raihanheriandry/sinam-fg3/documentation/water_level.jpg

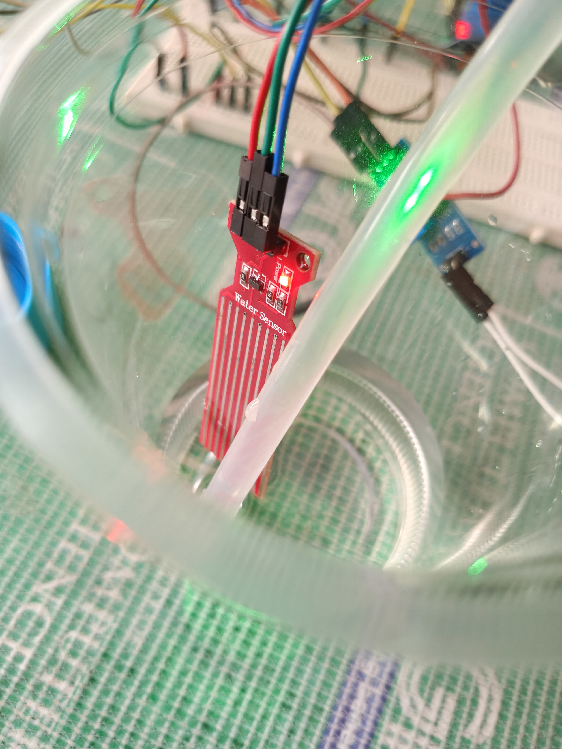
documentation/water_level.jpg
