raihanheriandry/sinam-fg3/documentation/soil.jpg

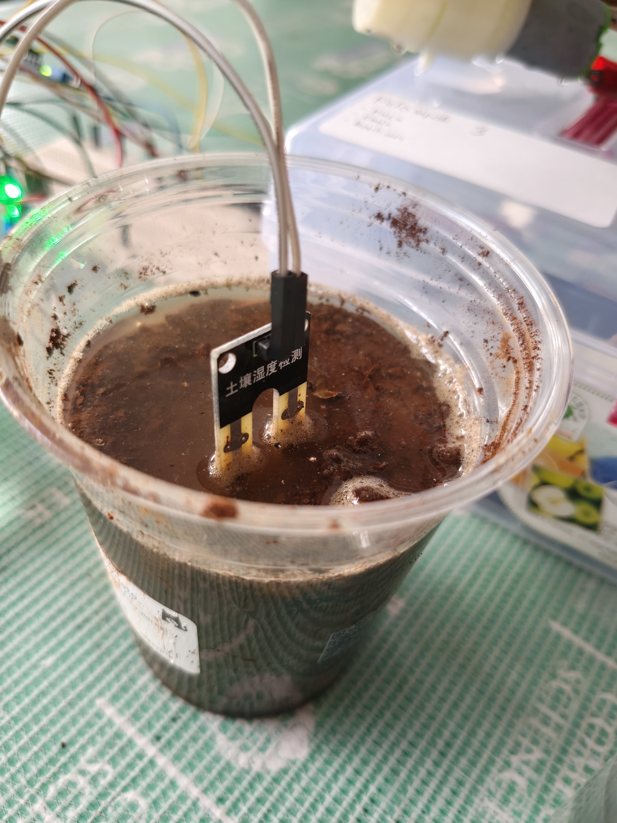
documentation/soil.jpg
