raihanheriandry/sinam-fg3/Slide_Presentasi_FG3.pdf

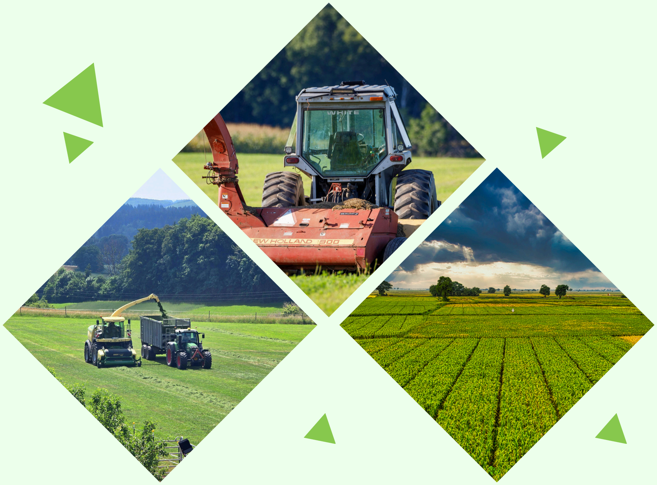
[picture p3: figure]

### Focus Group 3

Khansa Dinda Arya Putri - 2406496063 Rayyan Emir Muhammad - 2406345375 Raihan Maulana Heriandry - 2406351024

# Smart Irrigation System

### Sistem Tertanam 2026/2027

# Overview

## Sistem irigasi cerdas dirancang untuk melakukan penyiraman berdasarkan tiga kondisi utama:

## Kelembapan tanah Ketersediaan air Kondisi hujan

## Arduino Mega 2560 menerima data dari ketiga sensor dan menentukan respons dua aktuator, yaitu servo sebagai pengatur katup dan water

pump sebagai pengalir air.

### TANAH KERING

+

### AIR TERSEDIA

+

### TIDAK HUJAN

⟶

## PENYIRAMAN AKTIF

Logika Utama Sistem

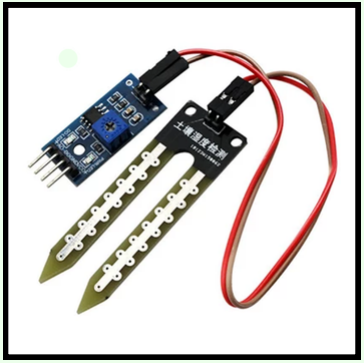
[picture p4: figure]
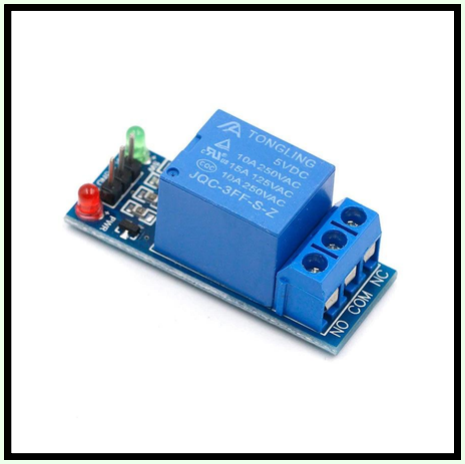
[picture p5: figure]
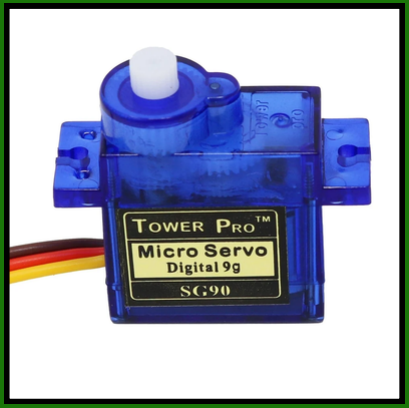
[picture p6: figure]

Servo
SG90
Sensor | Aktuator | Komponen Pendukung

Soil
Moisture
Sensor

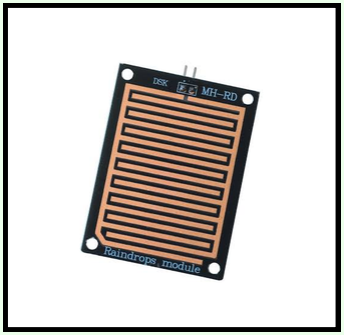
[picture p7: figure]
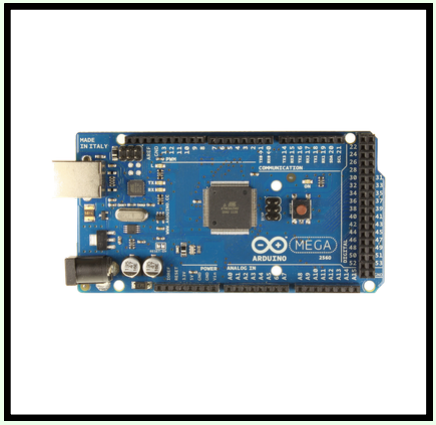
[picture p8: figure]

Raindrop
Module

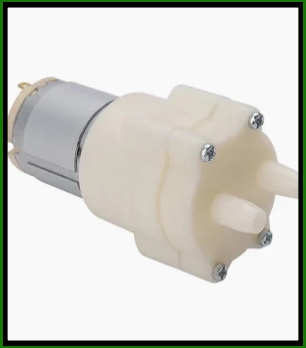
[picture p9: figure]
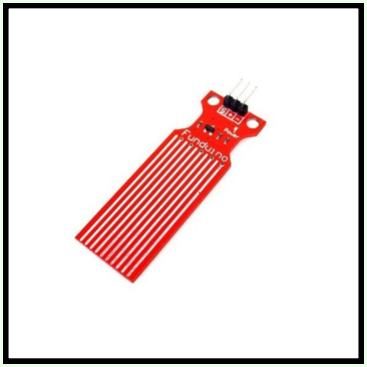
[picture p10: figure]
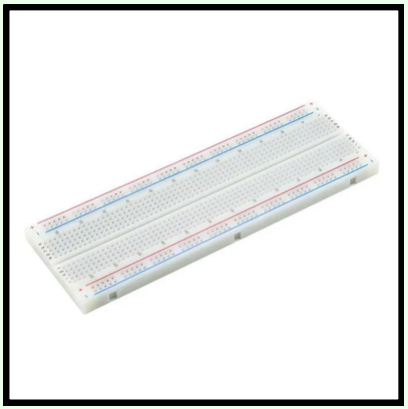
[picture p11: figure]

Water
Level
Sensor

Pump 12v

Power
Relay

Arduino
Mega 2560

Breadboard

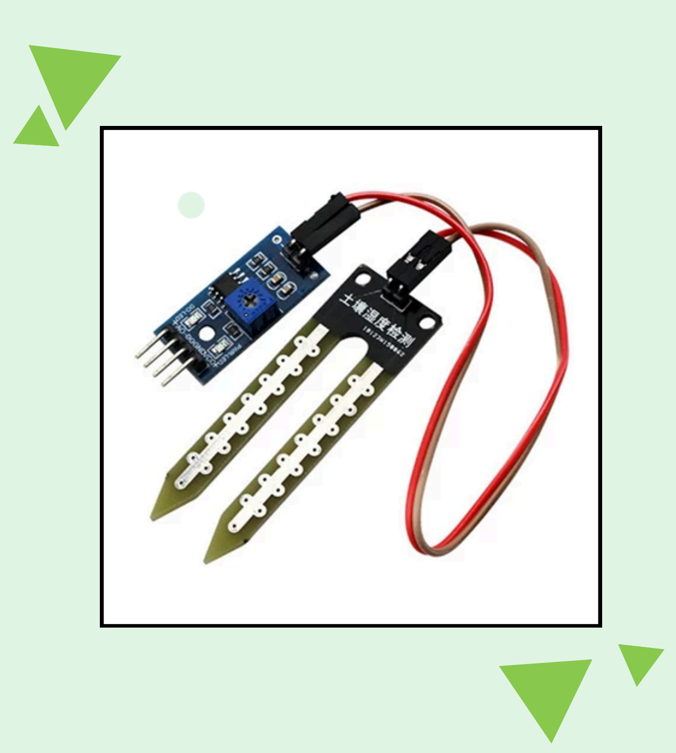
[picture p12: figure]

Fungsi:
Mendeteksi kondisi kelembapan tanah berdasarkan perubahan konduktivitas listrik pada media tanah.

Koneksi Arduino:
VCC → 5V
GND → GND
AO → Pin Analog
D0 → Pin Digital

Rentang nilai dari 0 - 1023 untuk analog. Nilai pembacaan cenderung lebih rendah pada kondisi basah dan lebih tinggi pada kondisi kering. Nilai aktual perlu dikalibrasi.

# Soil Moisture Sensor

FC-28

# Soil Moisture Sensor FC-28

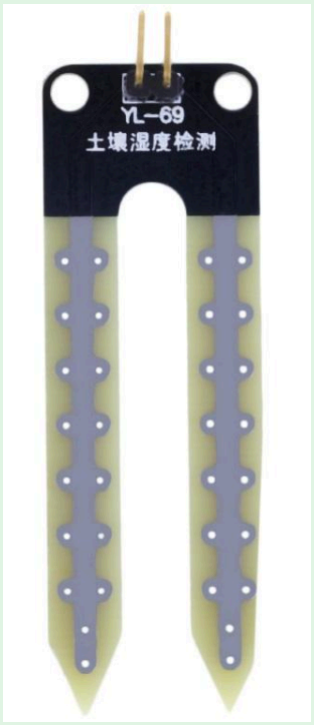
[picture p13: figure]
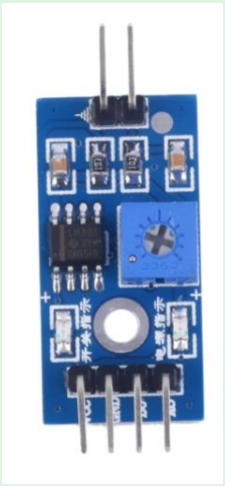
[picture p14: figure]

Probe atau garpu sensor

Dua bilah logam yang
ditancapkan ke tanah.

Sensor mendeteksi
perubahan konduktivitas
listrik | tanah | yang
berkaitan dengan kadar
airnya.

Modul pengolah sinyal

Papan biru yang mengolah sinyal sensor. Memiliki

AO (Analog Output): menghasilkan
nilai | yang | berubah | sesuai
kelembapan (0-1023).
DO (Digital Output): menghasilkan
status | HIGH/LOW | berdasarkan
ambang batas yang diatur.
Potensiometer: untuk mengatur ambang batas DO.

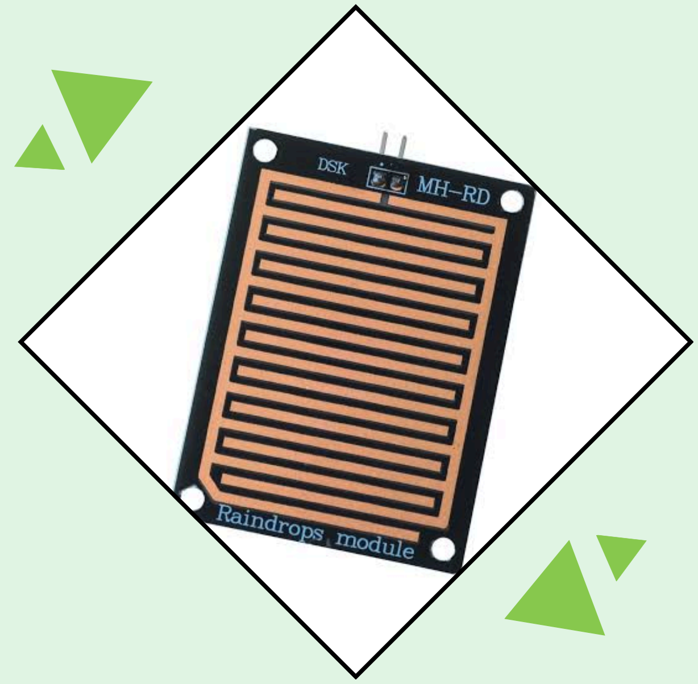
[picture p15: figure]

# Raindrop Module

Fungsi:
Mendeteksi keberadaan air atau kondisi hujan melalui perubahan karakteristik listrik pada permukaan sensor.

Koneksi Arduino:
VCC → 5V
GND → GND
AO → Pin Analog
DO → Pin Digital

Rentang nilai dari 0 - 1023 untuk analog. Nilai pembacaan cenderung lebih rendah pada kondisi basah dan lebih tinggi pada kondisi kering. Nilai aktual perlu dikalibrasi.

# Raindrop Module

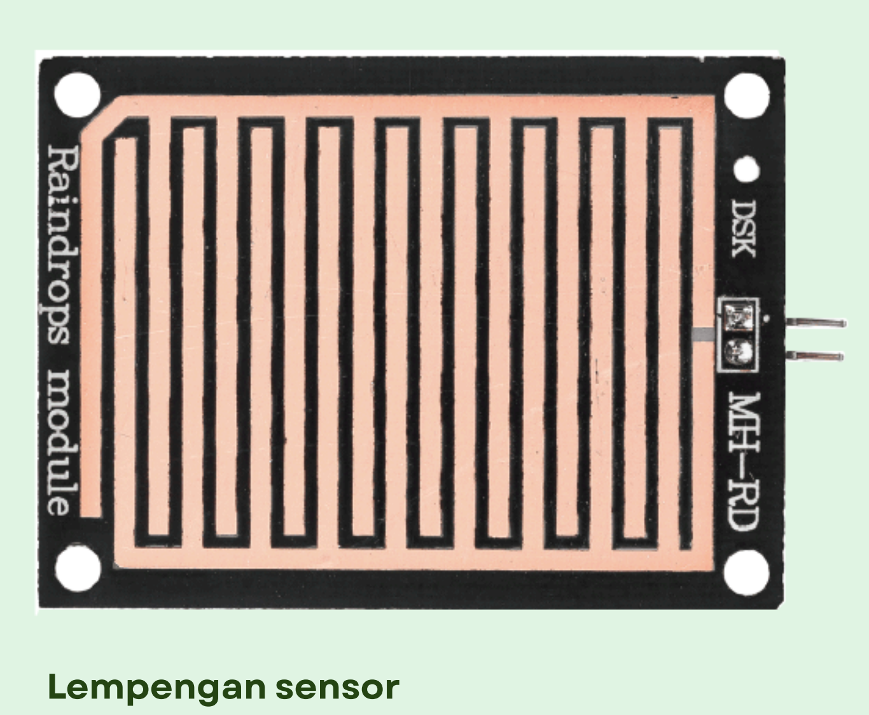
[picture p16: figure]
Lempengan sensor

Mendeteksi air atau tetesan hujan. Memiliki jalur-jalur konduktif.
Dihubungkan ke modul biru dengan 2 kabel

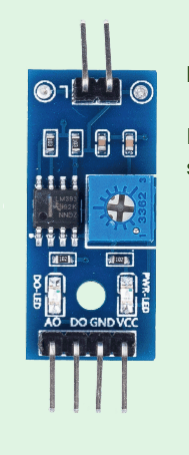
[picture p17: figure]

Modul pengolah sinyal

Papan biru yang mengolah sinyal sensor. Memiliki

AO (Analog Output): menghasilkan
nilai | yang | berubah | sesuai
kelembapan (0-1023).
DO (Digital Output): menghasilkan
status | HIGH/LOW | berdasarkan
ambang batas yang diatur.
Potensiometer: untuk mengatur ambang batas DO.

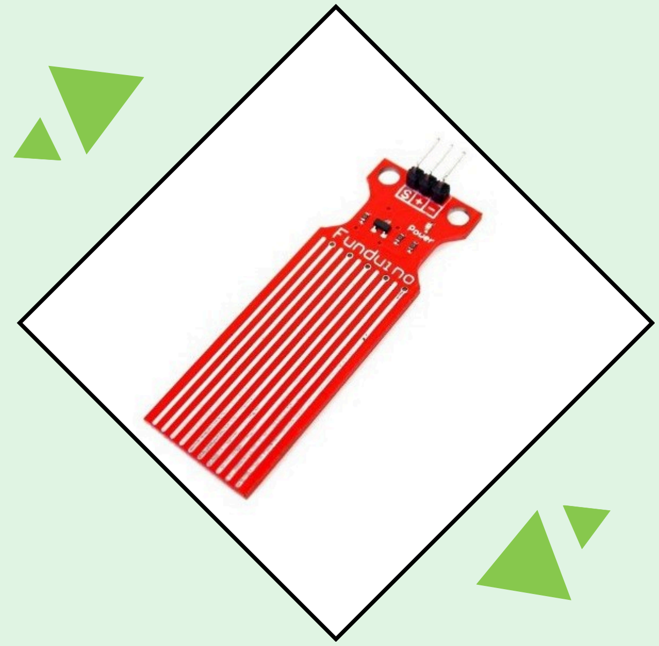
[picture p18: figure]

# Water Level Sensor ARD2-3025

Fungsi:
Mendeteksi ketersediaan air pada wadah penampungan berdasarkan perubahan sinyal analog ketika permukaan sensor bersentuhan dengan air.
Koneksi Arduino:
VCC → 5V
GND → GND
S ⟶ A1
Rentang nilai dari 0 - 1023
0 berarti air sangat rendah 1023 berarti air sangat tinggi

# Micro Servo SG90

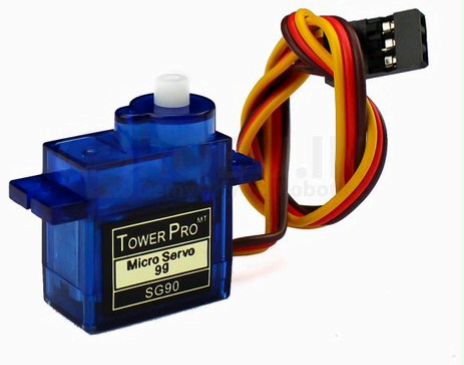
[picture p19: figure]

Fungsi:
Mengatur posisi katup air berdasarkan sinyal kontrol dari Arduino.

Koneksi Arduino:
Signal → D9
VCC → 5V
GND → GND

Menggunakan library Servo.h dengan fungsi writeMicroseconds() 1000 µs → Katup tertutup
1500 µs → Katup terbuka
Lebar pulsa tersebut menentukan posisi target servo dan dapat disesuaikan berdasarkan pemasangan mekanis katup.

# Pompa 12V (Water Pump R385)

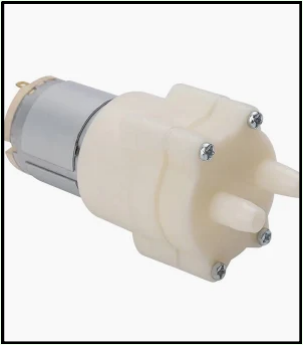
[picture p20: figure]

Fungsi:
Mendorong atau mengalirkan cairan (seperti air) dari satu tempat ke tempat lain berdasarkan instruksi kontrol dari Arduino.

Koneksi Arduino:
VCC (+) → Catu Daya Eksternal (+)
GND (-) → GND Catu Daya & GND Arduino
Control → Pin Digital Arduino (Melalui Relay)

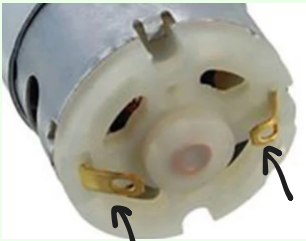
[picture p21: figure]

Terdapat 2 kawat tembaga yang bisa dihubungkan ke + dan - catu daya

# Power Relay JQC-3FF-S-Z

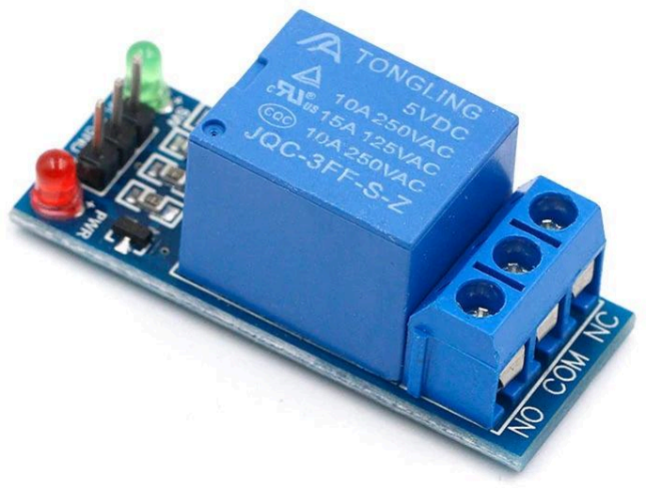
[picture p22: figure]

Fungsi:

Sebagai sakelar elektromagnetik (power relay) yang dikendalikan oleh arus kecil (dari mikrokontroler seperti Arduino atau sensor)
untuk | memutus | atau | menghubungkan | rangkaian | listrik
bertegangan dan berarus lebih tinggi dengan aman.

Digunakan agar pompa aman untuk dihubungkan ke arduino, juga sekaligus jadi saklar

# Power Relay JQC-3FF-S-Z

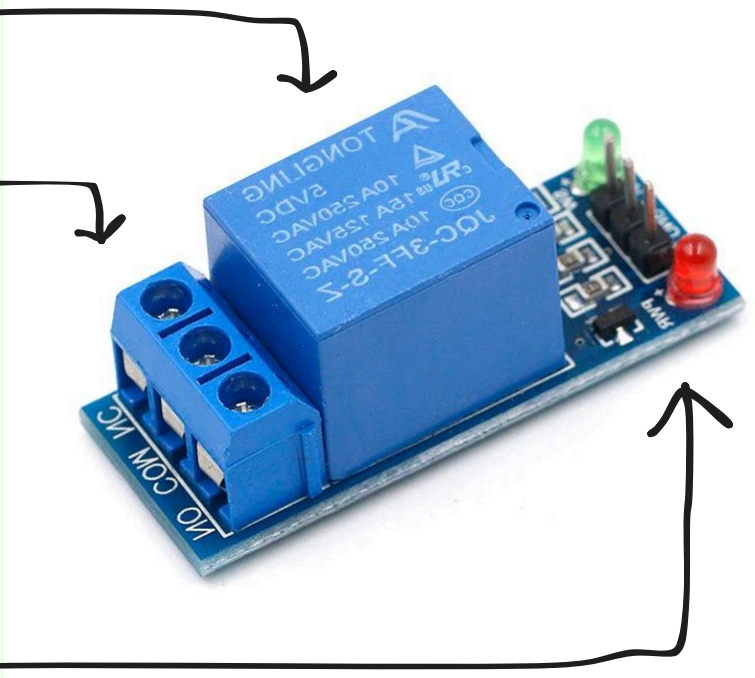
[picture p23: figure]

A. Kotak relay
Komponen berbentuk kotak biru atau hitam. Di dalamnya terdapat kumparan dan kontak saklar yang membuka atau menutup ketika relay diaktifkan
B. Terminal sekrup COM, NO, dan NC
COM: terminal kontak utama.
NO (Normally Open): terhubung ke COM ketika relay aktif.
NC (Normally Closed): terhubung ke COM ketika relay tidak aktif. Untuk pompa yang hanya menyala ketika relay aktif, umumnya digunakan COM dan NO.
C. Pin kontrol IN, VCC, dan GND
IN: menerima sinyal kendali dari Arduino.
VCC: sumber tegangan untuk rangkaian modul. GND: ground atau negatif rangkaian kontrol.

Komponen | Pin Arduino | Peran
Soil Moisture FC-28 | AO → A0 | Membaca kelembapan tanah
Water Level Sensor | S → A1 | Membaca ketersediaan air
Raindrop Module | AO → A2 | Membaca nilai analog hujan
Raindrop Module | DO → D2 | Mendeteksi perubahan kondisi digital melalui interrupt
Servo SG90 | Signal → D9 | Mengatur katup air
Relay Module | IN → D5 | Mengendalikan daya pompa

# Eksperimen Smart Irrigation Systems

Threshold yang digunakan dalam kode:
Tanah: nilai ≥ 500 berarti kering; nilai < 500 berarti basah.
Air: nilai ≥ 500 berarti air tersedia; nilai < 500 berarti air tidak tersedia. Hujan: sinyal digital LOW berarti hujan; HIGH berarti tidak hujan.

# Eksperimen Smart Irrigation Systems

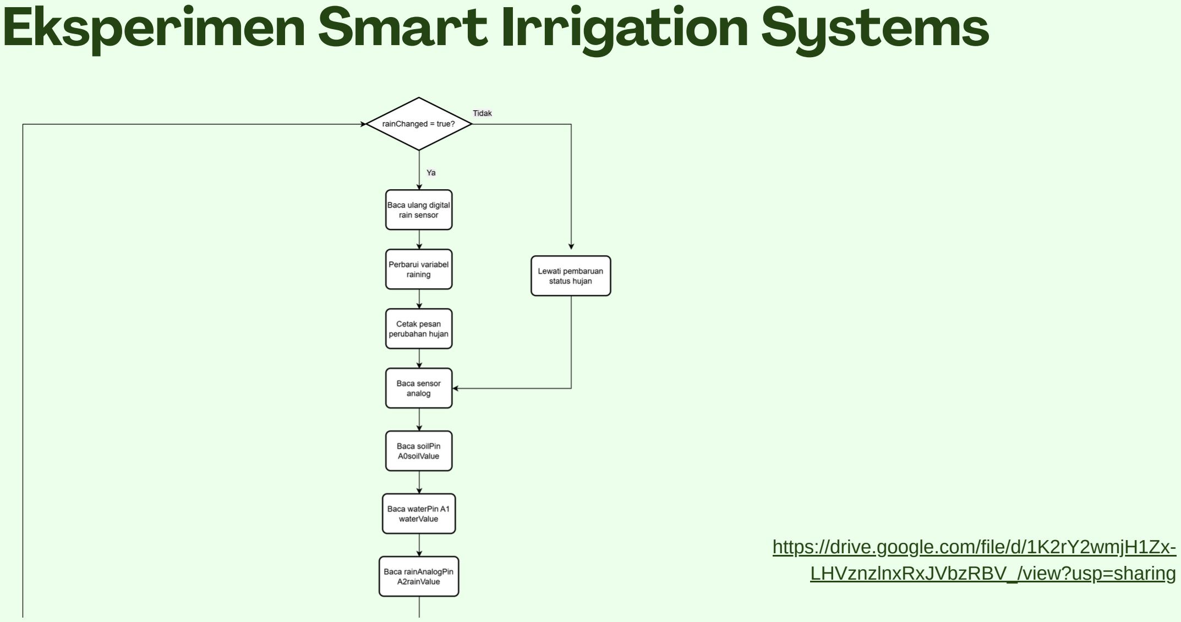
[picture p24: page 14]

https://drive.google.com/file/d/1K2rY2wmjH1Zx-LHVznzlnxRxJVbzRBV_/view?usp=sharing (https://drive.google.com/file/d/1K2rY2wmjH1Zx-LHVznzlnxRxJVbzRBV_/view?usp=sharing)

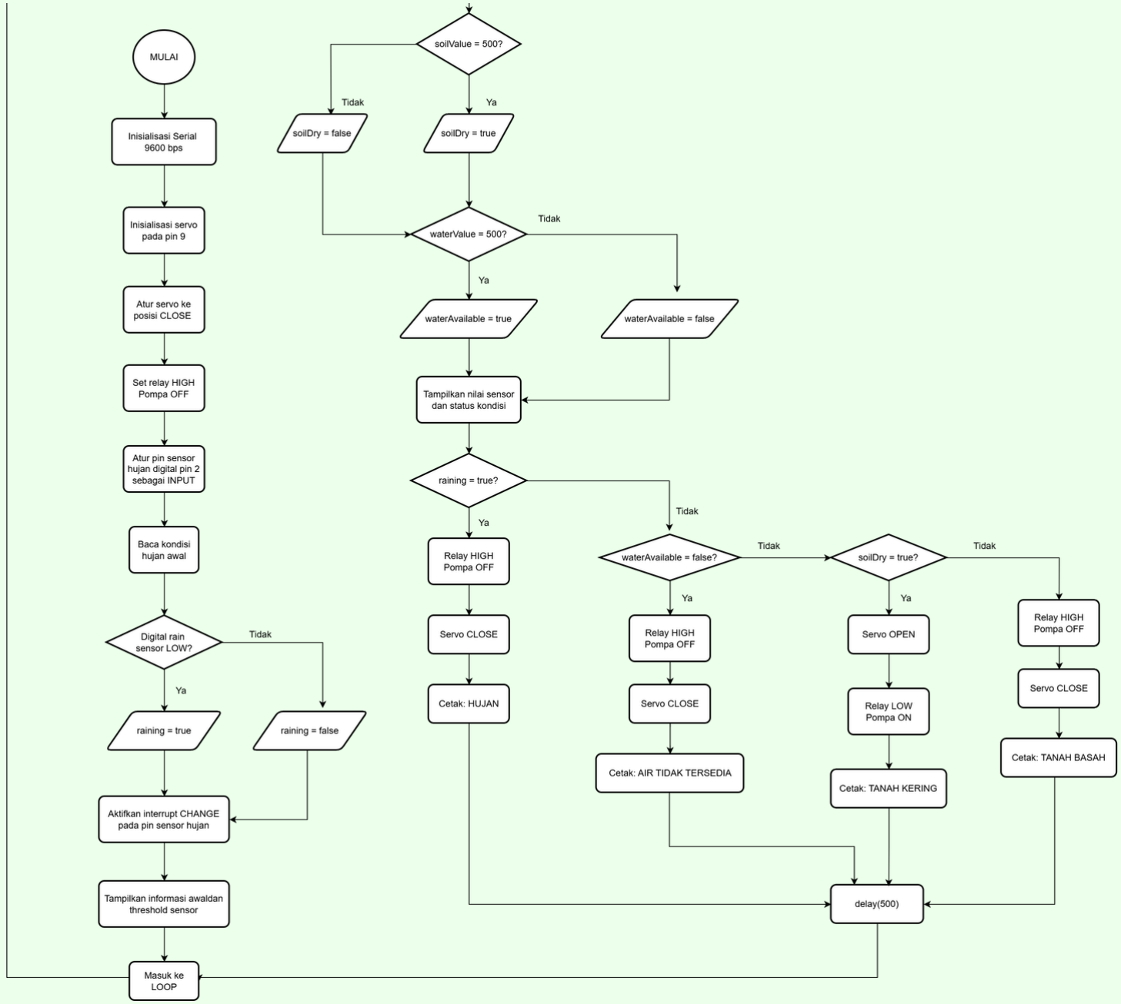
[picture p25: figure]

# ISR

Raindrop Module menggunakan pin digital D2 sebagai sumber external interrupt.

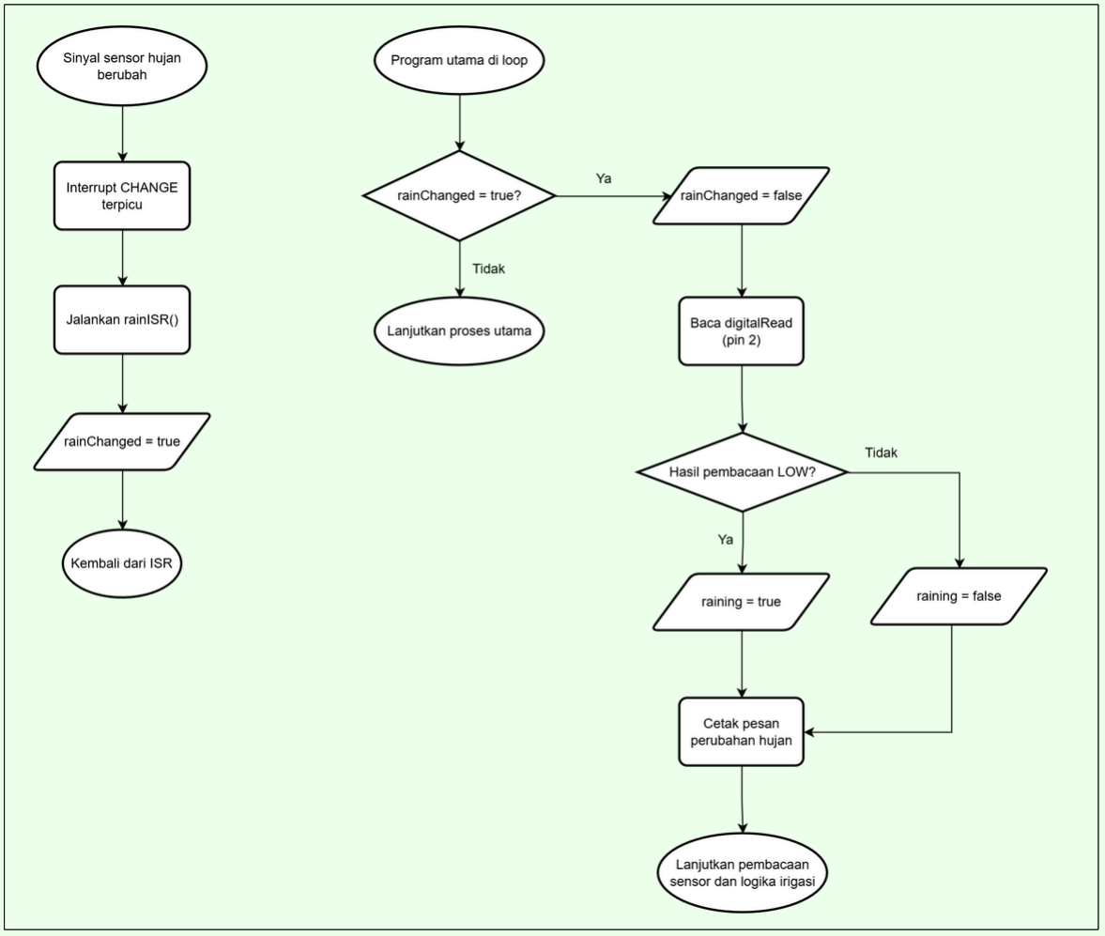
[picture p26: figure]

attachInterrupt(
digitalPinToInterrupt(rainDigitalPin),
rainISR,
CHANGE);

Mode CHANGE membuat interrupt dipicu ketika terjadi perubahan HIGH ⟶ LOW atau LOW ⟶ HIGH

ISR hanya memberikan tanda bahwa kondisi sensor berubah:

void rainISR() {
rainChanged = true;
}

Pemrosesan kondisi hujan selanjutnya dilakukan di dalam loop() agar ISR tetap singkat.

Prioritas | Kondisi | Posisi servo | Pompa
1 | Hujan terdeteksi | Tertutup | OFF
2 | Tidak hujan, air tidak tersedia | Tertutup | OFF
3 | Tidak hujan, air tersedia, tanah kering | Terbuka | ON
4 | Tidak hujan, air tersedia, tanah basah | Tertutup | OFF

# Eksperimen Smart Irrigation Systems

Inti eksperimen:
Arduino Mega 2560 membaca kelembapan tanah, ketersediaan air, dan kondisi hujan.
Data tersebut diperiksa secara berulang setiap 500 milidetik.
Sistem memprioritaskan kondisi hujan dan ketersediaan air sebelum memeriksa kelembapan tanah. Jika hujan terdeteksi atau air tidak tersedia, katup ditutup dan pompa dimatikan.
Jika tidak hujan, air tersedia, dan tanah kering, katup dibuka dan pompa dinyalakan.
Ketika tanah sudah basah, katup kembali ditutup dan pompa dimatikan

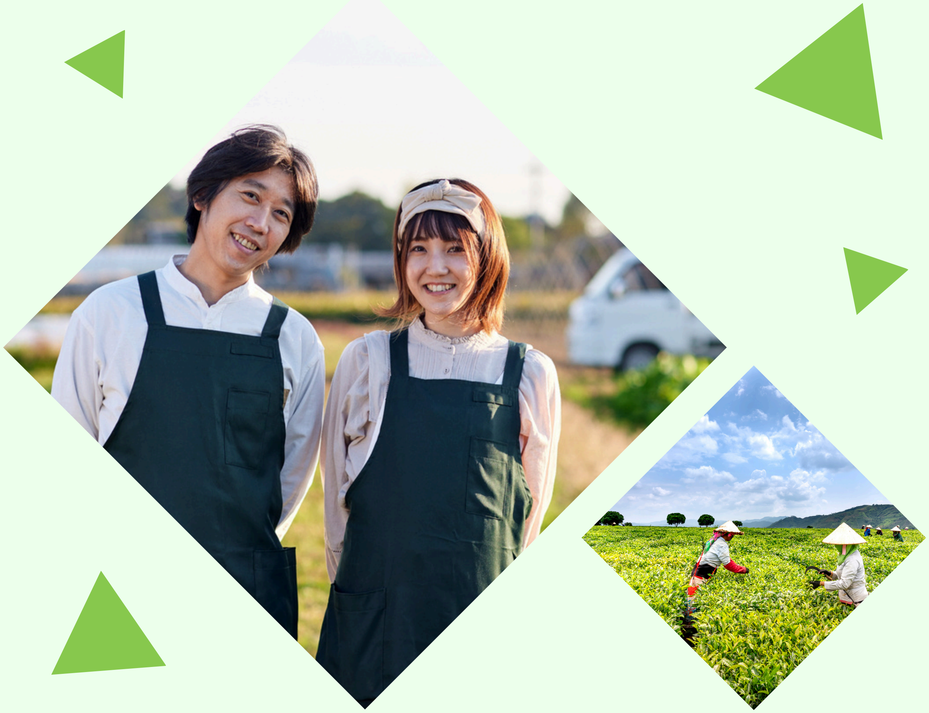
[picture p27: figure]

# Terima Kasih
