raihanheriandry/sinam-fg3/documentation/all.jpg

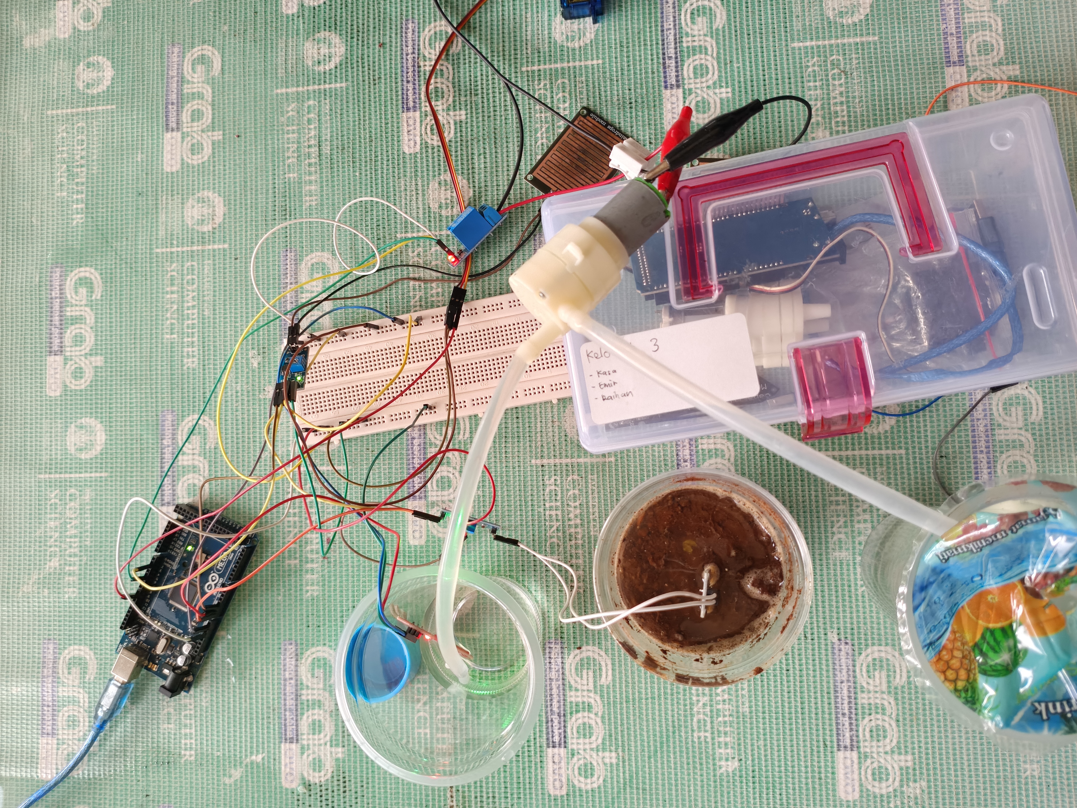
documentation/all.jpg
