raihanheriandry/sinam-fg3/documentation/arduino.jpg

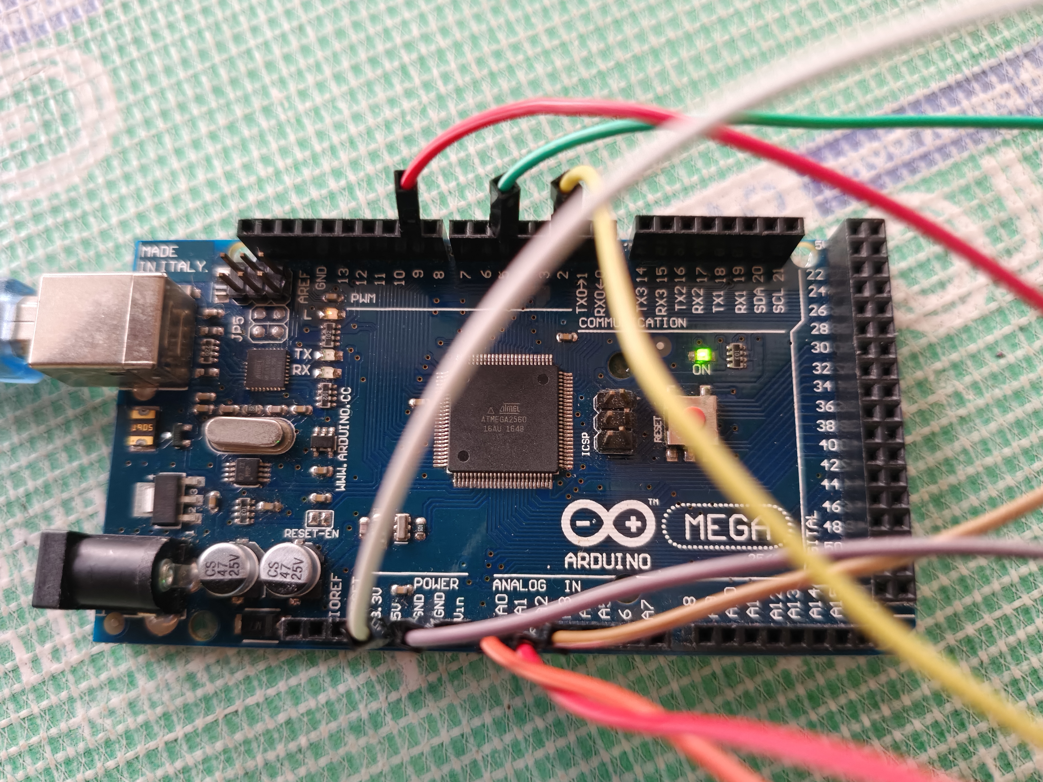
documentation/arduino.jpg
