raihanheriandry/sinam-fg3/documentation/breadboard.jpg

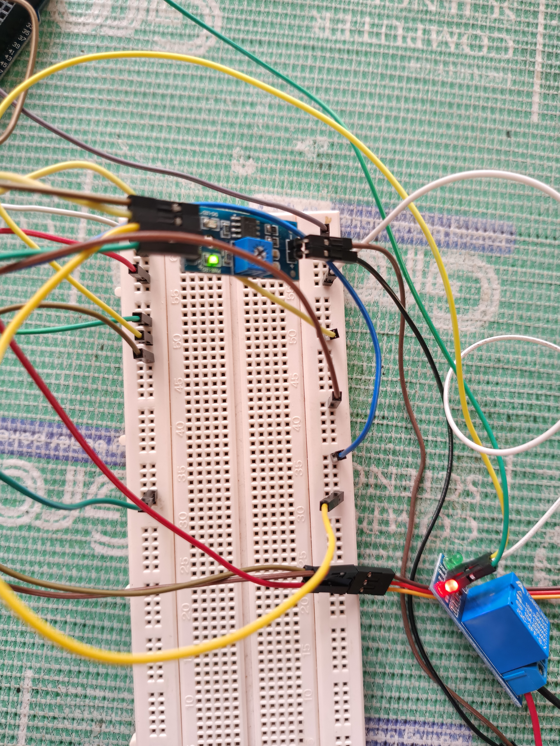
documentation/breadboard.jpg
