raihanheriandry/sinam-fg3/documentation/relay.jpg

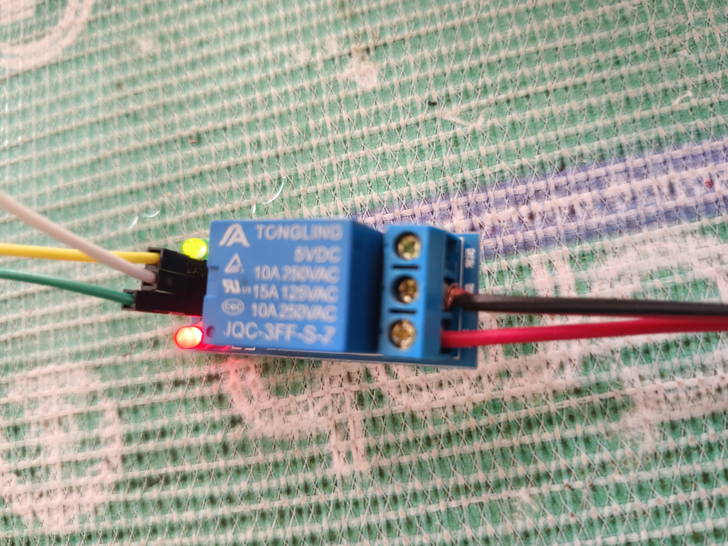
documentation/relay.jpg
