raihanheriandry/sinam-fg3/documentation/servo1.jpg

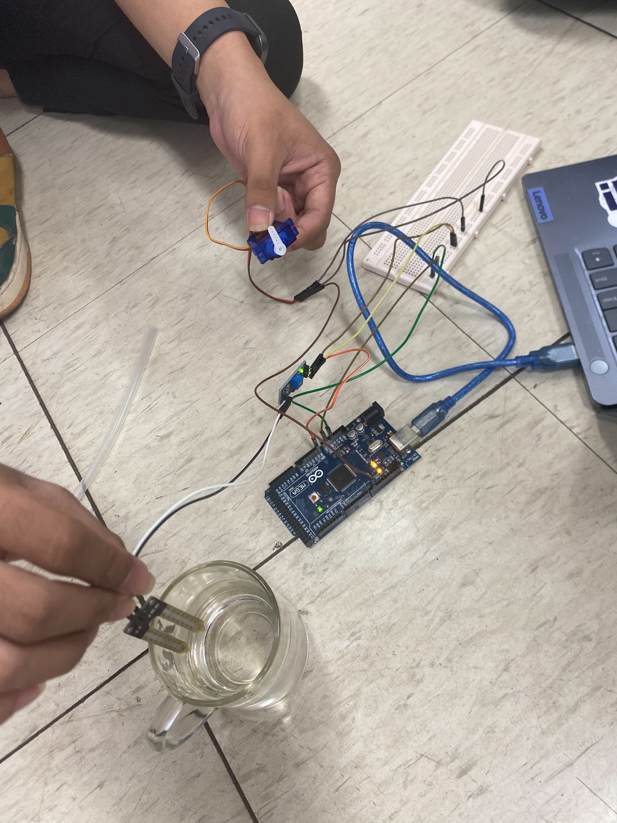
documentation/servo1.jpg
