raihanheriandry/sinam-fg3/documentation/servo.jpg

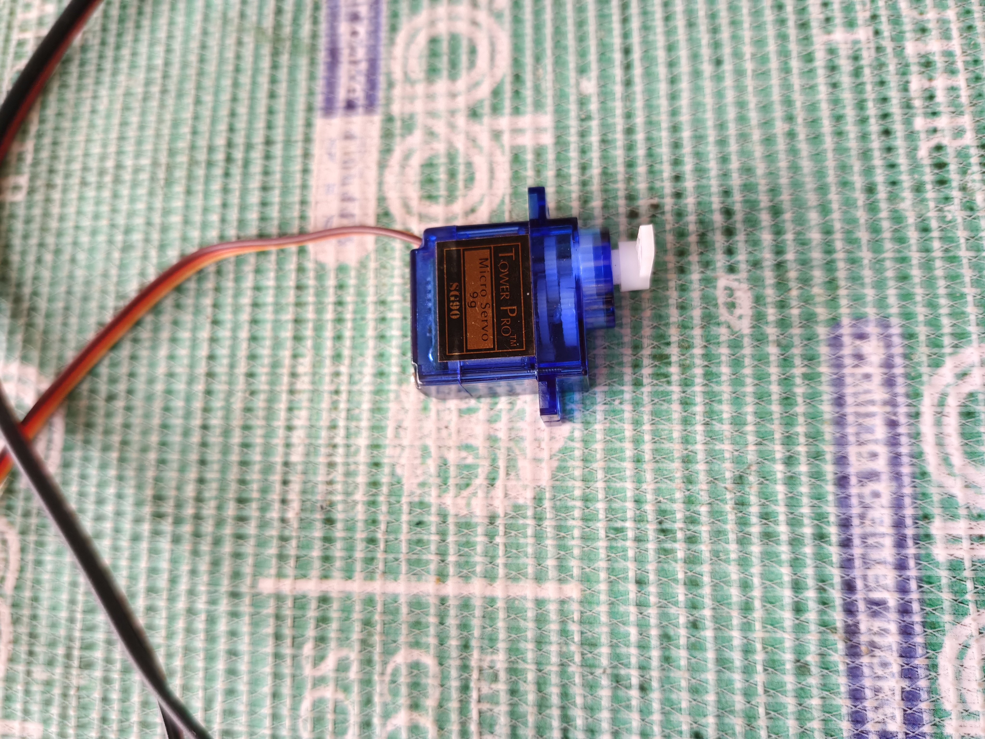
documentation/servo.jpg
