raihanheriandry/sinam-fg3/documentation/wokwi.png

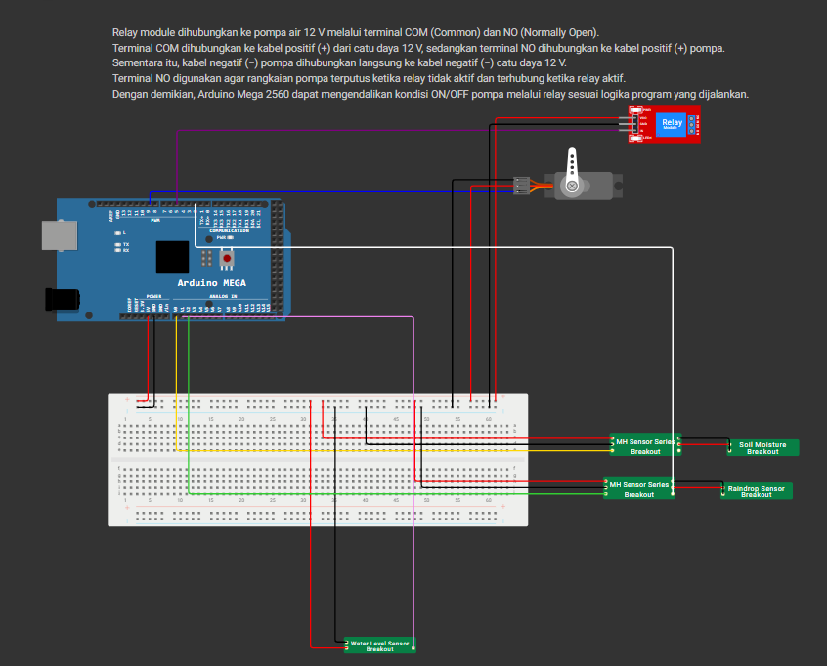
documentation/wokwi.png
