raihanheriandry/sinam-fg3/documentation/raindrop.jpg

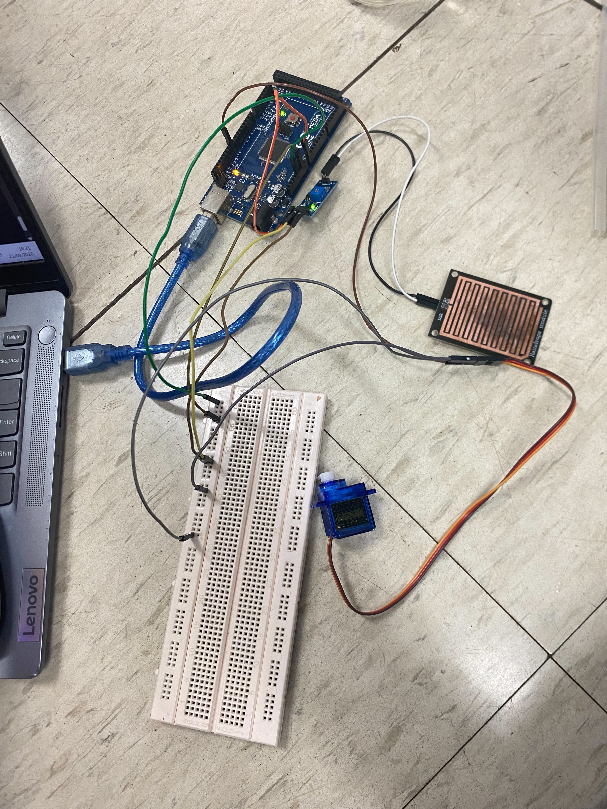
documentation/raindrop.jpg
